peach-e/LightSuit/(commit log)

2017-12-28 Finally have a new filtering algorithm
2017-12-28 Add total allocation level to normalization
    so you don't always have one color getting throttled.
